ryanbarry/eurorack-psu/eurorack-psu.kicad_pcb

## KiCad design eurorack-psu.kicad_pcb (2019-04-25)

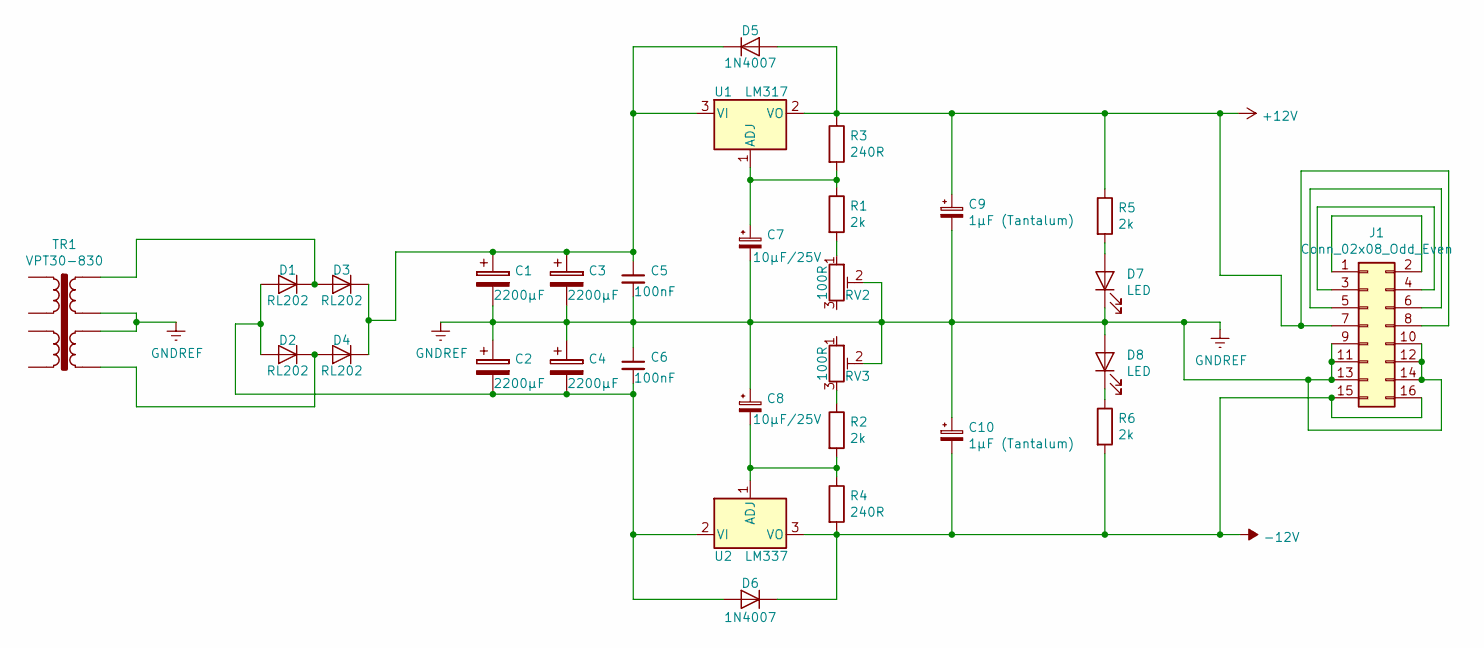
[picture p1: schematic eurorack-psu.sch]

Parts:
C1, C2, C3, C4: 2200µF; CP_Radial_D16.0mm_P7.50mm
C5, C6: 100nF; C_Disc_D4.3mm_W1.9mm_P5.00mm
C7, C8: 10µF/25V; CP_Radial_D5.0mm_P2.00mm
C9, C10: 1µF (Tantalum); CP_Radial_Tantal_D5.0mm_P5.00mm
D1, D2, D3, D4: RL202; D_DO-15_P5.08mm_Vertical_AnodeUp
D5, D6: 1N4007; D_DO-35_SOD27_P2.54mm_Vertical_KathodeUp
D7, D8: LED; LED_D3.0mm
J1: Conn_02x08_Odd_Even; Socket_Strip_Straight_2x08_Pitch2.54mm
R1, R2, R5, R6: 2k; R_Axial_DIN0207_L6.3mm_D2.5mm_P7.62mm_Horizontal
R3, R4: 240R; R_Axial_DIN0207_L6.3mm_D2.5mm_P7.62mm_Horizontal
RV2, RV3: 100R; Potentiometer_Trimmer_Bourns_3266P
TR1: VPT30-830; Transformer_Toroidal_D74.0mm_OffBoardMount
U1: LM317; TO-220
U2: LM337; TO-220

Connections:
+12V: C9.1, D5.2 (A), J1.7, J1.8, R3.1, R5.1, U1.2 (VO)
-12V: C10.2, D6.1 (K), J1.15, J1.16, R4.2, R6.2, U2.3 (VO)
GNDREF: C1.2, C2.1, C3.2, C4.1, C5.2, C6.1, C7.2, C8.1, C9.2, C10.1, D7.1 (K), D8.2 (A), J1.9, J1.10, J1.11, J1.12, J1.13, J1.14, RV2.2, RV3.1, RV3.2, TR1.6, TR1.7
unnamed: C1.1, C3.1, C5.1, D3.1 (K), D4.1 (K), D5.1 (K), U1.3 (VI)
unnamed: C2.2, C4.2, C6.2, D1.2 (A), D2.2 (A), D6.2 (A), U2.2 (VI)
unnamed: C7.1, R1.1, R3.2, U1.1 (ADJ)
unnamed: C8.2, R2.2, R4.1, U2.1 (ADJ)
unnamed: D1.1 (K), D3.2 (A), TR1.8
unnamed: D2.1 (K), D4.2 (A), TR1.5
unnamed: D7.2 (A), R5.2
unnamed: D8.1 (K), R6.1
unnamed: J1.1, J1.2
unnamed: J1.3, J1.4
unnamed: J1.5, J1.6
unnamed: R1.2, RV2.1
unnamed: R2.1, RV3.3

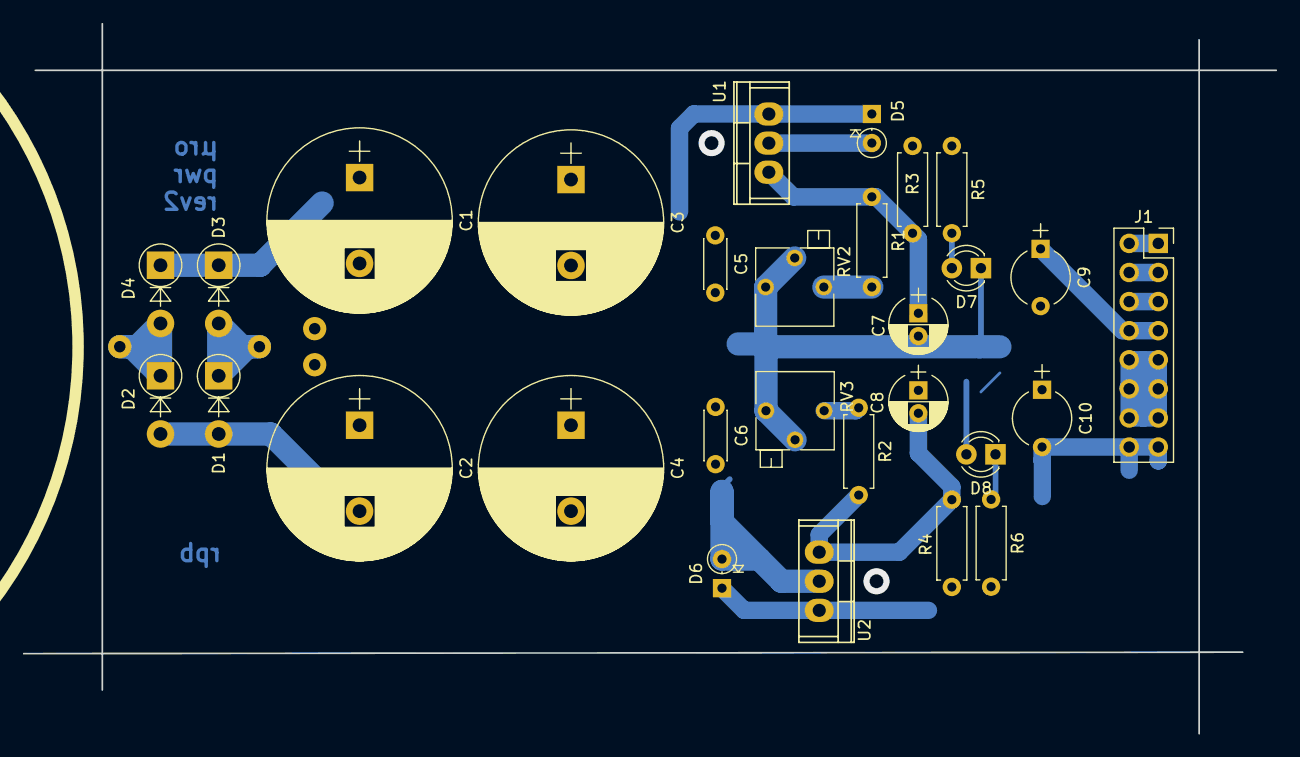
[picture p2: board eurorack-psu.kicad_pcb from above]

Board: 2 copper layers, 109.3 x 62.0 mm, 30 parts (0 on the bottom side), 16 nets.
