ryanbarry/eurorack-psu/(commit log)

2018-11-16 rev1 of schematic, pcb, and fabrication
    [eurorack-psu-B.Cu.gbr, eurorack-psu-B.Mask.gbr, eurorack-psu-Edge.Cuts.gbr, eurorack-psu-F.Cu.gbr, eurorack-psu-F.Mask.gbr, eurorack-psu-F.Paste.gbr, eurorack-psu-F.SilkS.gbr, eurorack-psu.drl]
2018-11-16 make holes bigger for txfmr leads
2018-11-16 use new txfmr footprint, move trimmers further apart
    the trimmers were colliding (footprint outline is too small) and txfmr
    leads are too thick to fit through the default sized vias
    [eurorack-psu.kicad_pcb]
2018-11-16 use larger minimum trace size for more reliable engraving
    [eurorack-psu.kicad_pcb]
2018-11-17 rev2 pcb design w/ copper graphics and fabrication files
    [eurorack-psu-B.Cu.gbr, eurorack-psu-B.Mask.gbr, eurorack-psu-Edge.Cuts.gbr, eurorack-psu-F.Cu.gbr, eurorack-psu-F.Mask.gbr, eurorack-psu-F.Paste.gbr, eurorack-psu-F.SilkS.gbr, eurorack-psu.drl]
2019-04-25 rm oshw mark, tweak some stuff
    [eurorack-psu.kicad_pcb, eurorack-psu.sch]
